PujanBhandari/Ball-balancing-platform/README.md

# Ball-balancing-platform
Development of control engineering demonstration setup.

The software is used for the teaching purpose that helps the user to understand the working principle and the practical aspects of the PID controller in an interactive way. To compile the software successfully, it is necessary to have the images (used for the Graphical User Interface, provided in the .zip file) saved in the same folder containing the .py file.
