PujanBhandari/Ball-balancing-platform/Exploded view_Ball balancing beam.png

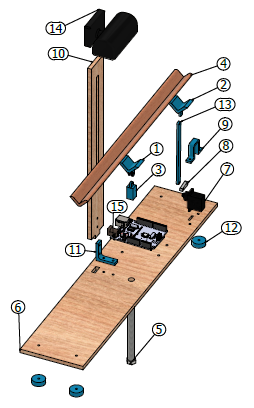
Exploded view_Ball balancing beam.png
