PujanBhandari/Ball-balancing-platform/GUI overview.png

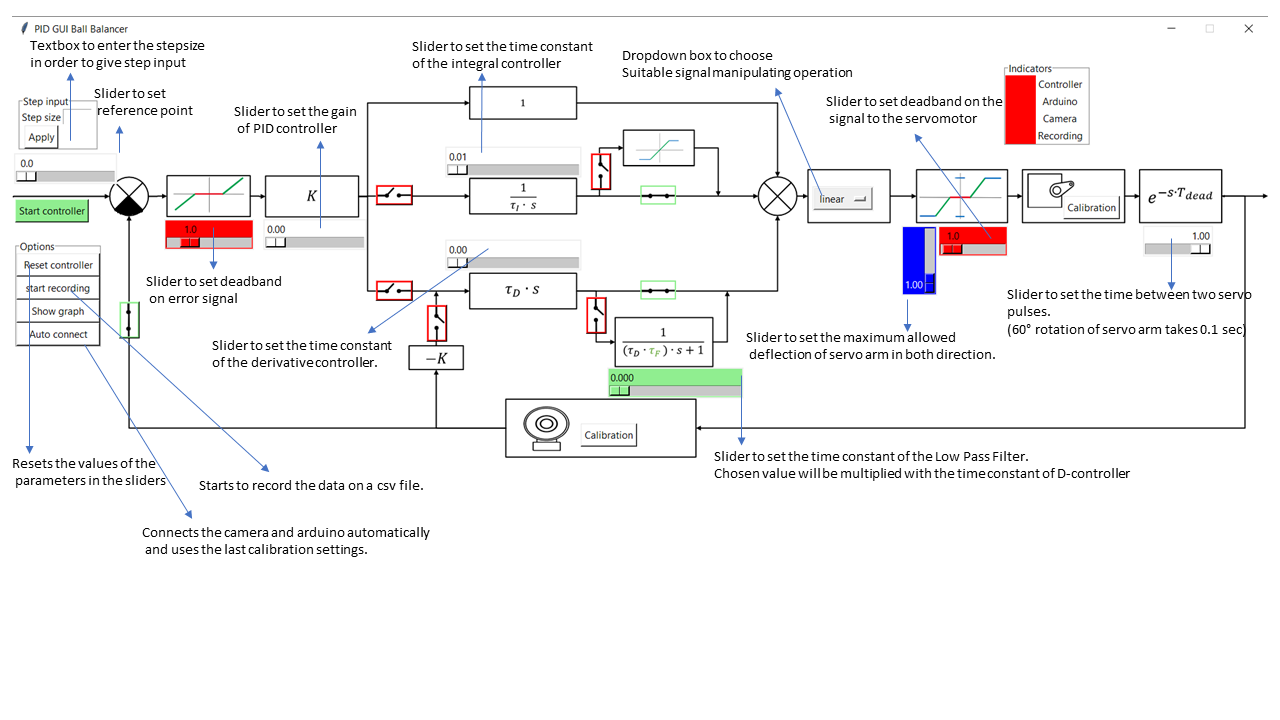
GUI overview.png
