PujanBhandari/Ball-balancing-platform/DrawingsBallBalancingBeam.pdf

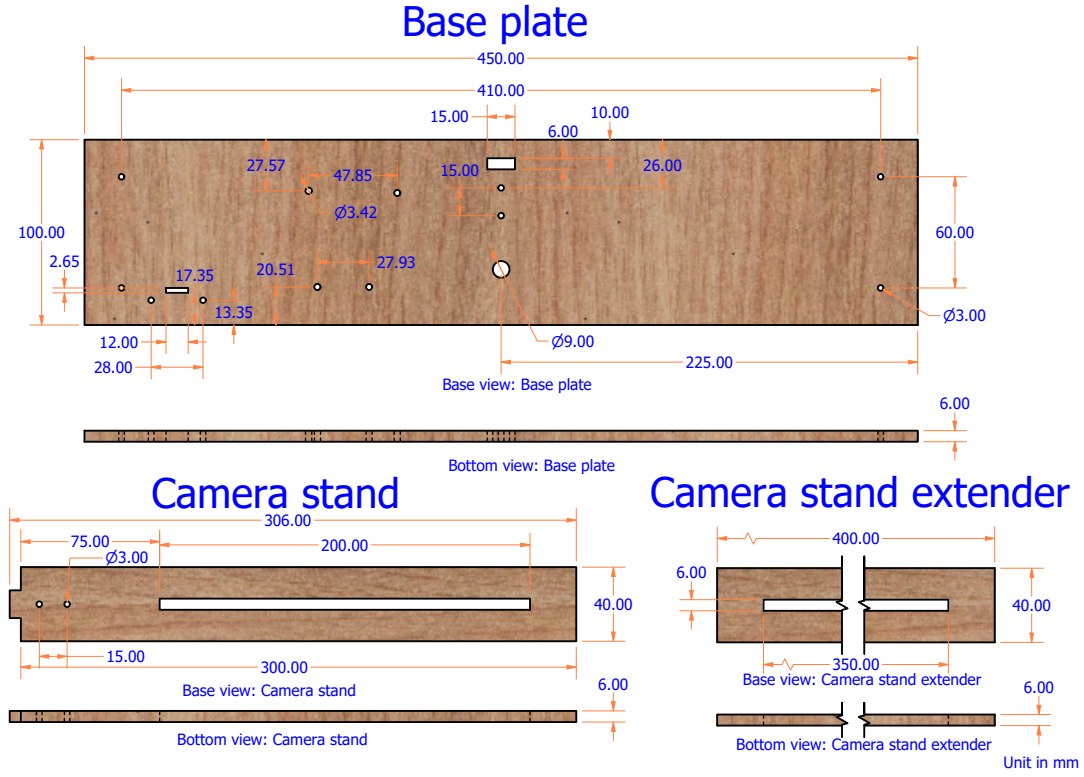
[picture p17: page 1]
Base plate; Camera stand; Camera stand extender

Base view: Base plate

Bottom view: Base plate

Base view: Camera stand extender

6.00 Base view: Camera stand

Bottom view: Camera stand

Bottom view: Camera stand extender

Unit in mm

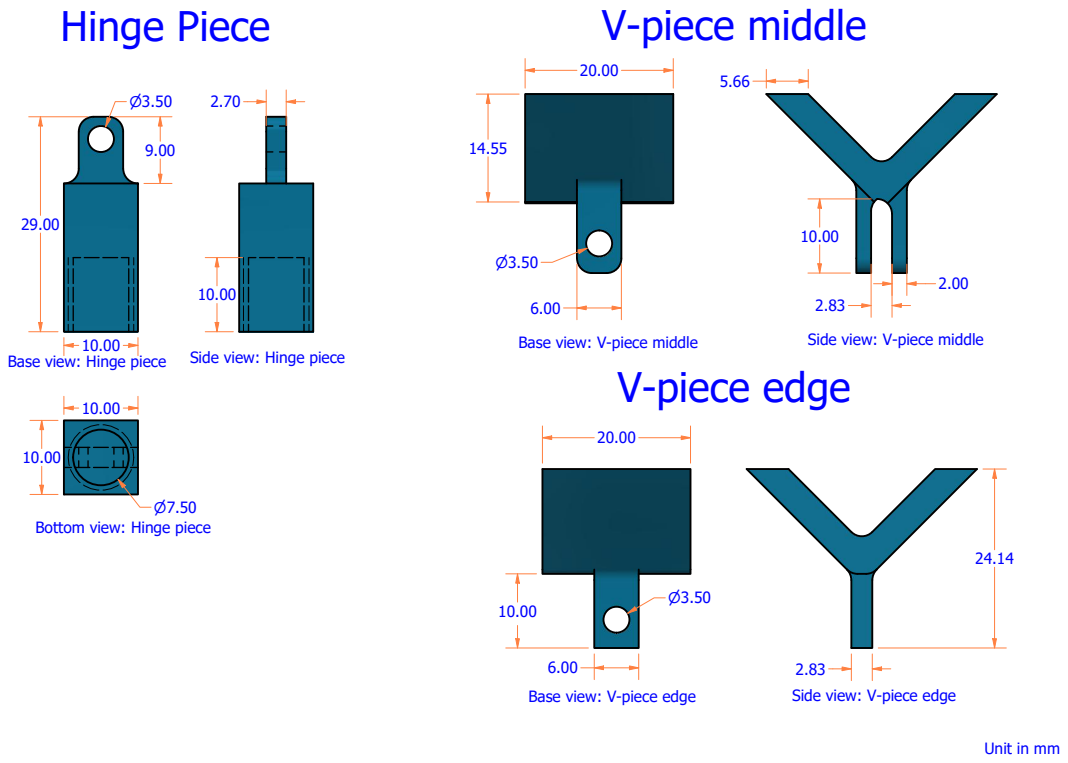
[picture p18: page 2]
Hinge Piece; Base view: Hinge piece; Side view: Hinge piece; V-piece middle; V-piece edge; Base view: V-piece middle; Side view: V-piece middle; Base view: V-piece edge; Side view: V-piece edge

Bottom view: Hinge piece

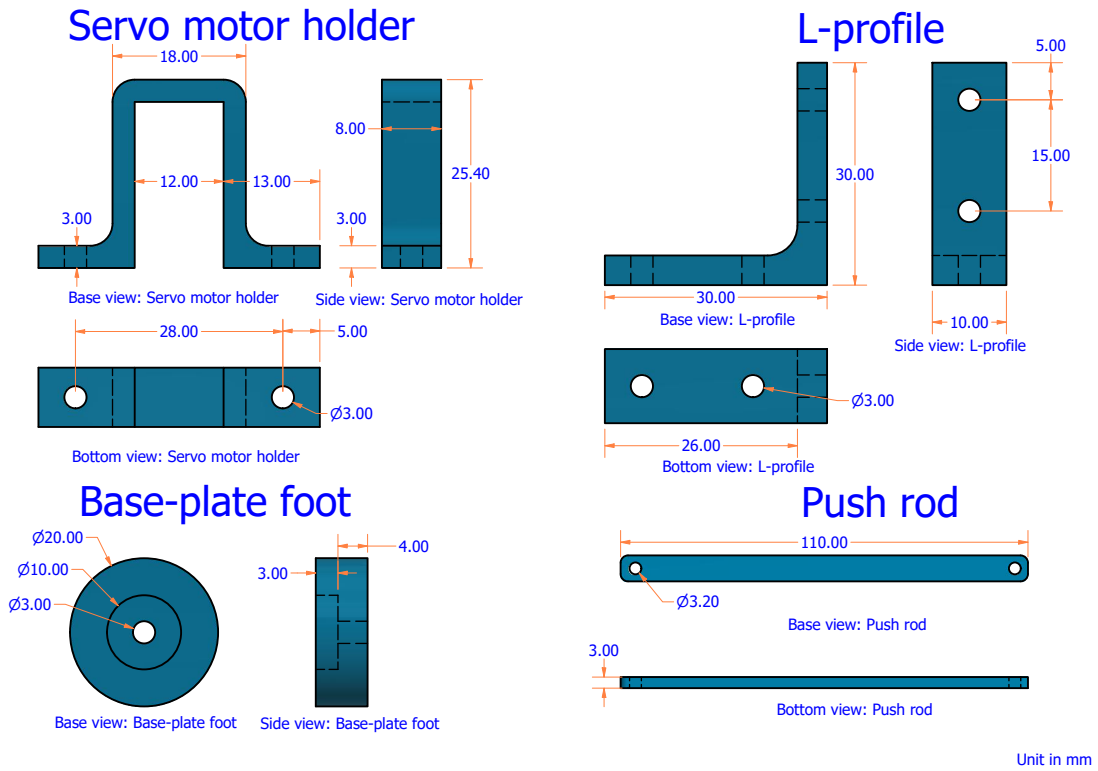
[picture p19: page 3]
Servo motor holder; L-profile; Push rod; Base view: Servo motor holder; Side view: Servo motor holder; Base view: Base-plate foot; Side view: Base-plate foot

Base view: L-profile

Side view: L-profile

Bottom view: L-profile

Bottom view: Servo motor holder
Base-plate foot

Base view: Push rod

Bottom view: Push rod
