PujanBhandari/Ball-balancing-platform/ExplodedView_BallBalancingPlate.pdf

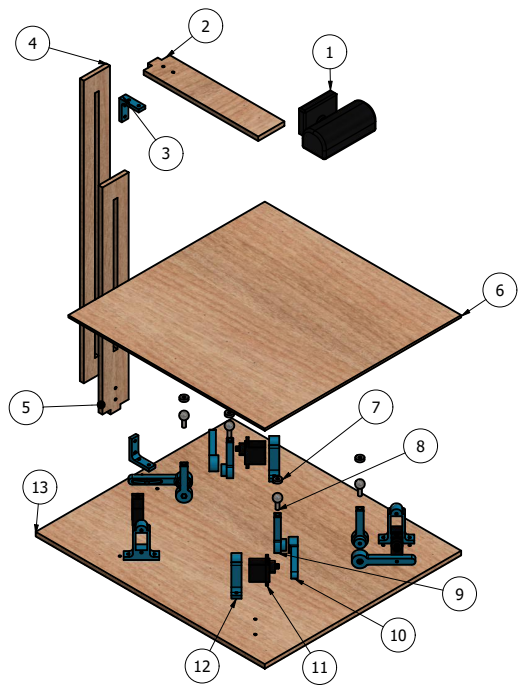
[picture p24: page 1]
